danielfdzperez/arduinoRobot/(commit log)

2017-11-09 make file que acepta headers, common convertido a header
2017-11-09 Aprovechada la biblioteca common
    Y añadido un nivel de abstracción
2017-11-11 tiempos funcionan. enviar cadenas de caracteres y clear
2017-11-12 Añadida funcionalidad para escribir numeros en pantalla
    Se le puede pasar un número entero a sendInteger y lo escribirá por pantalla
2017-11-13 Añadida funcionalidad para situar el cursor en una fila y columna
2017-11-16 Arreglado el parpadeo por interrupciones
    Falta conseguir que funcionen las interrupciones que sí queremos
    [lcd.c]
2017-11-17 Añadido el fichero de cabeceras para LCD
    Ahora hay que desarrollar las interrupciones en timer.c
2017-12-23 Control del servo
2017-12-23 Creado la carpeta remporales, arduinoRobot.ino integrado ping y lcd. Actualizado lcd
2017-12-23 Documentación del controlador del servo.
2018-01-03 Lectura de botones integrada, pero no para el robot final
2018-01-10 Soporte con PID para el motor
2018-01-10 Cambiado el motor para que funcione con el timer de 64 MHz
2018-01-11 Añadido soporte para controlar los dos motores
    Ahora se pueden controlar los dos motores y se ha documentado el código
2018-01-11 servo integrado, estados del robot.
2018-01-11 Revert "Añadido soporte para controlar los dos motores"
    This reverts commit c4f49dcf714dec4ac07fde6e7f25ea9464c615da.
2018-01-11 Revert "Revert "Añadido soporte para controlar los dos motores""
    This reverts commit 709126cd6d7199b26c6843f4dd8b3ebe57644201.
2018-01-11 Funciona motor.ino con dos motores
2018-01-12 Iniciada la documentación del proyecto
    Me siento más cómodo con el formato org, la documentación pasa a estar
    en README.org. Se ha confeccionado el esqueleto y se ha empezado a
    describir los componentes físicos.
2018-01-12 Añadidas las referencias hasta ahora para no añadirlas todas al final
2018-01-12 prueba de inserción de imagen a otro servidor
2018-01-12 Mejora de gráficos
2018-01-13 Actualizado el README
2018-01-13 Botones funcionan, solucionado error estado
    [arduinoRobot.ino]
2018-01-14 Añadido esquema de conexión y mejorado diagrama de estados
2018-01-14 Añadida explicación más a fondo sobre las interrupciones y el pwm
2018-01-14 Cambios comportamiento robot, libreria PID sin if
2018-01-16 algo del pid
2018-01-17 Tiempo para PID añadido
2018-01-21 delay para computar el PID
